techav-homebrew/Wrap030/Software/MultiBasic/libc/00readme.md

This is a subset of gcc libiberty required for the ff library. It is derived from gcc source via https://github.com/gcc-mirror/gcc/
