techav-homebrew/Wrap030/ExpansionBoards/ATX-PSU_8b/039301240.stp

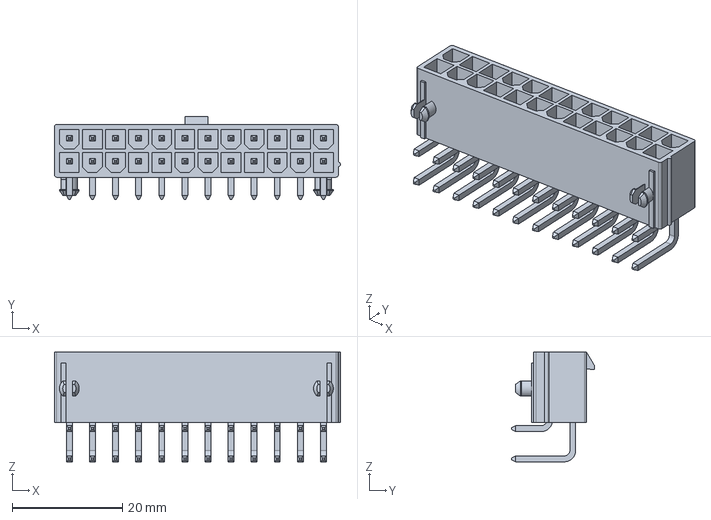
[picture p1: CAD file, 2025-03-29]
ExpansionBoards/ATX-PSU_8b/039301240.stp
52.0 x 15.0 x 19.9 mm
