techav-homebrew/Wrap030/ExpansionBoards/ATX-PSU_8b/ATX-PSU_8b.kicad_pcb

## KiCad design ExpansionBoards/ATX-PSU_8b/ATX-PSU_8b.kicad_pcb (2025-03-29)

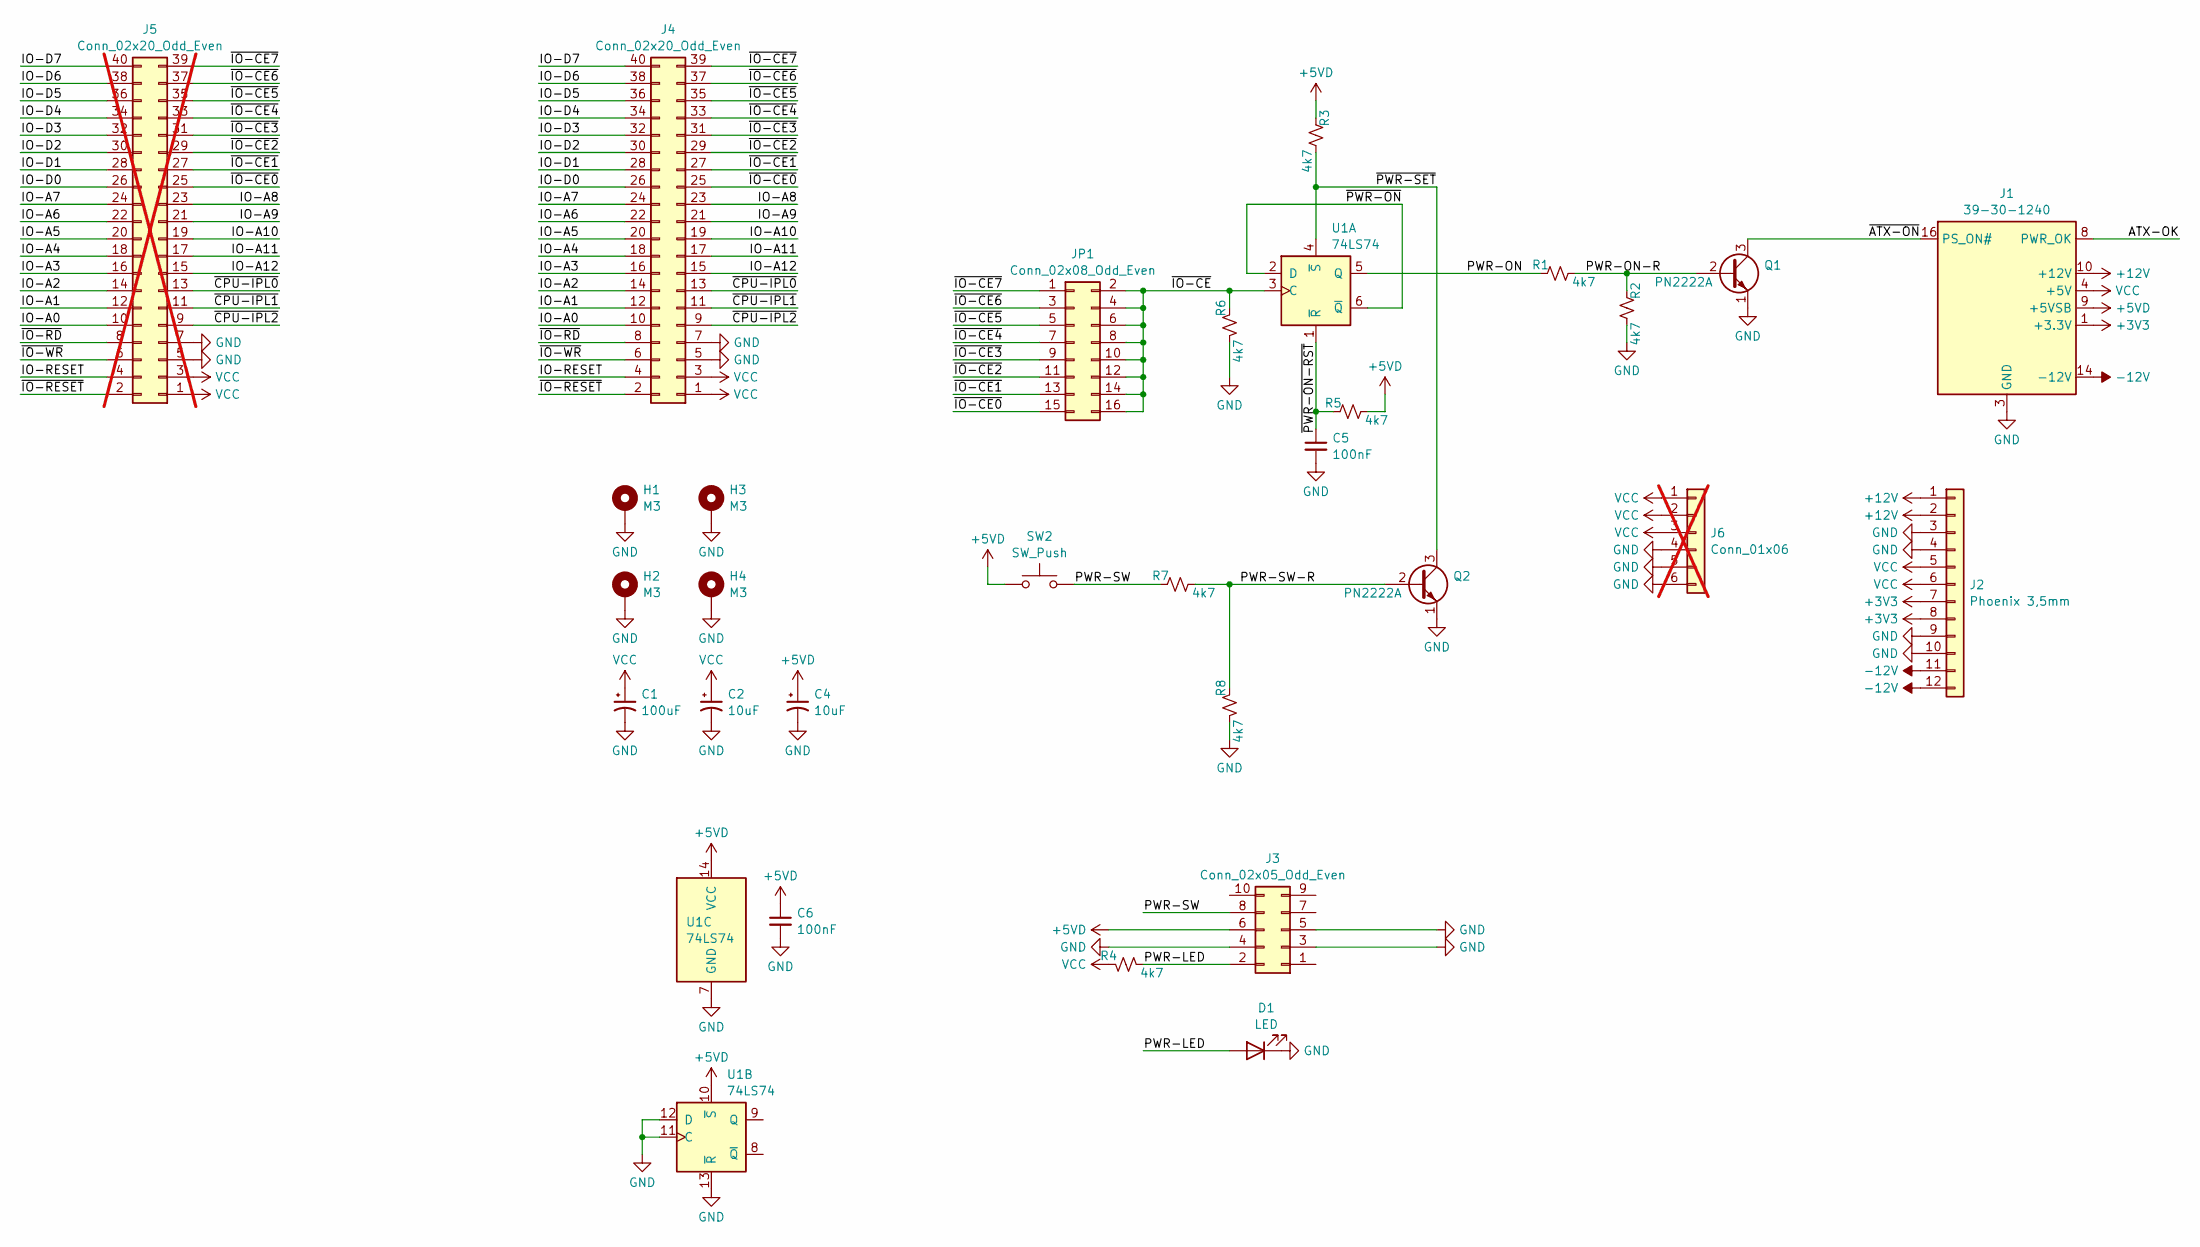
[picture p2: schematic ATX-PSU_8b.kicad_sch]

Parts:
C1: 100uF; CP_Radial_D10.0mm_P5.00mm
C2, C4: 10uF; CP_Radial_D5.0mm_P2.50mm
C5, C6: 100nF; C_Disc_D4.3mm_W1.9mm_P5.00mm
D1: LED; LED_D3.0mm
H1, H2, H3, H4: M3; MountingHole_3.2mm_M3_Pad_Via
J1: 39-30-1240; Molex_Mini-Fit_Jr_5569-24A2_2x12_P4.20mm_Horizontal; Mouser 538-39-30-1240
J2: Phoenix 3,5mm; PhoenixContact_MC_1,5_12-G-3.5_1x12_P3.50mm_Horizontal
J3: Conn_02x05_Odd_Even; IDC-Header_2x05_P2.54mm_Vertical
J4: Conn_02x20_Odd_Even; PinHeader_2x20_P2.54mm_Horizontal
J5: Conn_02x20_Odd_Even; PinHeader_2x20_P2.54mm_Vertical; not fitted
J6: Conn_01x06; PinHeader_1x06_P2.54mm_Vertical; not fitted
JP1: Conn_02x08_Odd_Even; PinHeader_2x08_P2.54mm_Vertical
Q1, Q2: PN2222A; TO-92_Inline
R1, R2, R3, R4, R5, R6, R7, R8: 4k7; R_Axial_DIN0204_L3.6mm_D1.6mm_P7.62mm_Horizontal
SW2: SW_Push; SW_PUSH_6mm_H4.3mm
U1: 74LS74; DIP-14_W7.62mm

Connections:
+3V3: J1.1 (+3.3V), J1.2 (+3.3V), J1.12 (+3.3V), J1.13 (+3.3V), J2.7, J2.8
+5VD: C4.1, C6.1, J1.9 (+5VSB), J3.6, R3.1, R5.2, SW2.1, U1.10 (~S), U1.14 (VCC)
+12V: J1.10 (+12V), J1.11 (+12V), J2.1, J2.2
-12V: J1.14 (-12V), J2.11, J2.12
/ATX-OK: J1.8 (PWR_OK)
/IO-A0: J4.10, J5.10
/IO-A1: J4.12, J5.12
/IO-A2: J4.14, J5.14
/IO-A3: J4.16, J5.16
/IO-A4: J4.18, J5.18
/IO-A5: J4.20, J5.20
/IO-A6: J4.22, J5.22
/IO-A7: J4.24, J5.24
/IO-A8: J4.23, J5.23
/IO-A9: J4.21, J5.21
/IO-A10: J4.19, J5.19
/IO-A11: J4.17, J5.17
/IO-A12: J4.15, J5.15
/IO-D0: J4.26, J5.26
/IO-D1: J4.28, J5.28
/IO-D2: J4.30, J5.30
/IO-D3: J4.32, J5.32
/IO-D4: J4.34, J5.34
/IO-D5: J4.36, J5.36
/IO-D6: J4.38, J5.38
/IO-D7: J4.40, J5.40
/IO-RESET: J4.4, J5.4
/PWR-LED: D1.2 (A), J3.2, R4.1
/PWR-ON: R1.1, U1.5 (Q)
/PWR-ON-R: Q1.2 (B), R1.2, R2.1
/PWR-SW: J3.8, R7.1, SW2.2
/PWR-SW-R: Q2.2 (B), R7.2, R8.1
/~ATX-ON: J1.16 (PS_ON#), Q1.3 (C)
/~CPU-IPL0: J4.13, J5.13
/~CPU-IPL1: J4.11, J5.11
/~CPU-IPL2: J4.9, J5.9
/~IO-CE0: J4.25, J5.25, JP1.15
/~IO-CE1: J4.27, J5.27, JP1.13
/~IO-CE2: J4.29, J5.29, JP1.11
/~IO-CE3: J4.31, J5.31, JP1.9
/~IO-CE4: J4.33, J5.33, JP1.7
/~IO-CE5: J4.35, J5.35, JP1.5
/~IO-CE6: J4.37, J5.37, JP1.3
/~IO-CE7: J4.39, J5.39, JP1.1
/~IO-CE: JP1.2, JP1.4, JP1.6, JP1.8, JP1.10, JP1.12, JP1.14, JP1.16, R6.1, U1.3 (C)
/~IO-RD: J4.8, J5.8
/~IO-RESET: J4.2, J5.2
/~IO-WR: J4.6, J5.6
/~PWR-ON-RST: C5.1, R5.1, U1.1 (~R)
/~PWR-ON: U1.2 (D), U1.6 (~Q)
/~PWR-SET: Q2.3 (C), R3.2, U1.4 (~S)
GND: C1.2, C2.2, C4.2, C5.2, C6.2, D1.1 (K), H1.1, H2.1, H3.1, H4.1, J1.3 (GND), J1.5 (GND), J1.7 (GND), J1.15 (GND), J1.17 (GND), J1.18 (GND), J1.19 (GND), J1.24 (GND), J2.3, J2.4, J2.9, J2.10, J3.3, J3.4, J3.5, J4.5, J4.7, J5.5, J5.7, J6.4, J6.5, J6.6, Q1.1 (E), Q2.1 (E), R2.2, R6.2, R8.2, U1.7 (GND), U1.11 (C), U1.12 (D), U1.13 (~R)
VCC: C1.1, C2.1, J1.4 (+5V), J1.6 (+5V), J1.21 (+5V), J1.22 (+5V), J1.23 (+5V), J2.5, J2.6, J4.1, J4.3, J5.1, J5.3, J6.1, J6.2, J6.3, R4.2

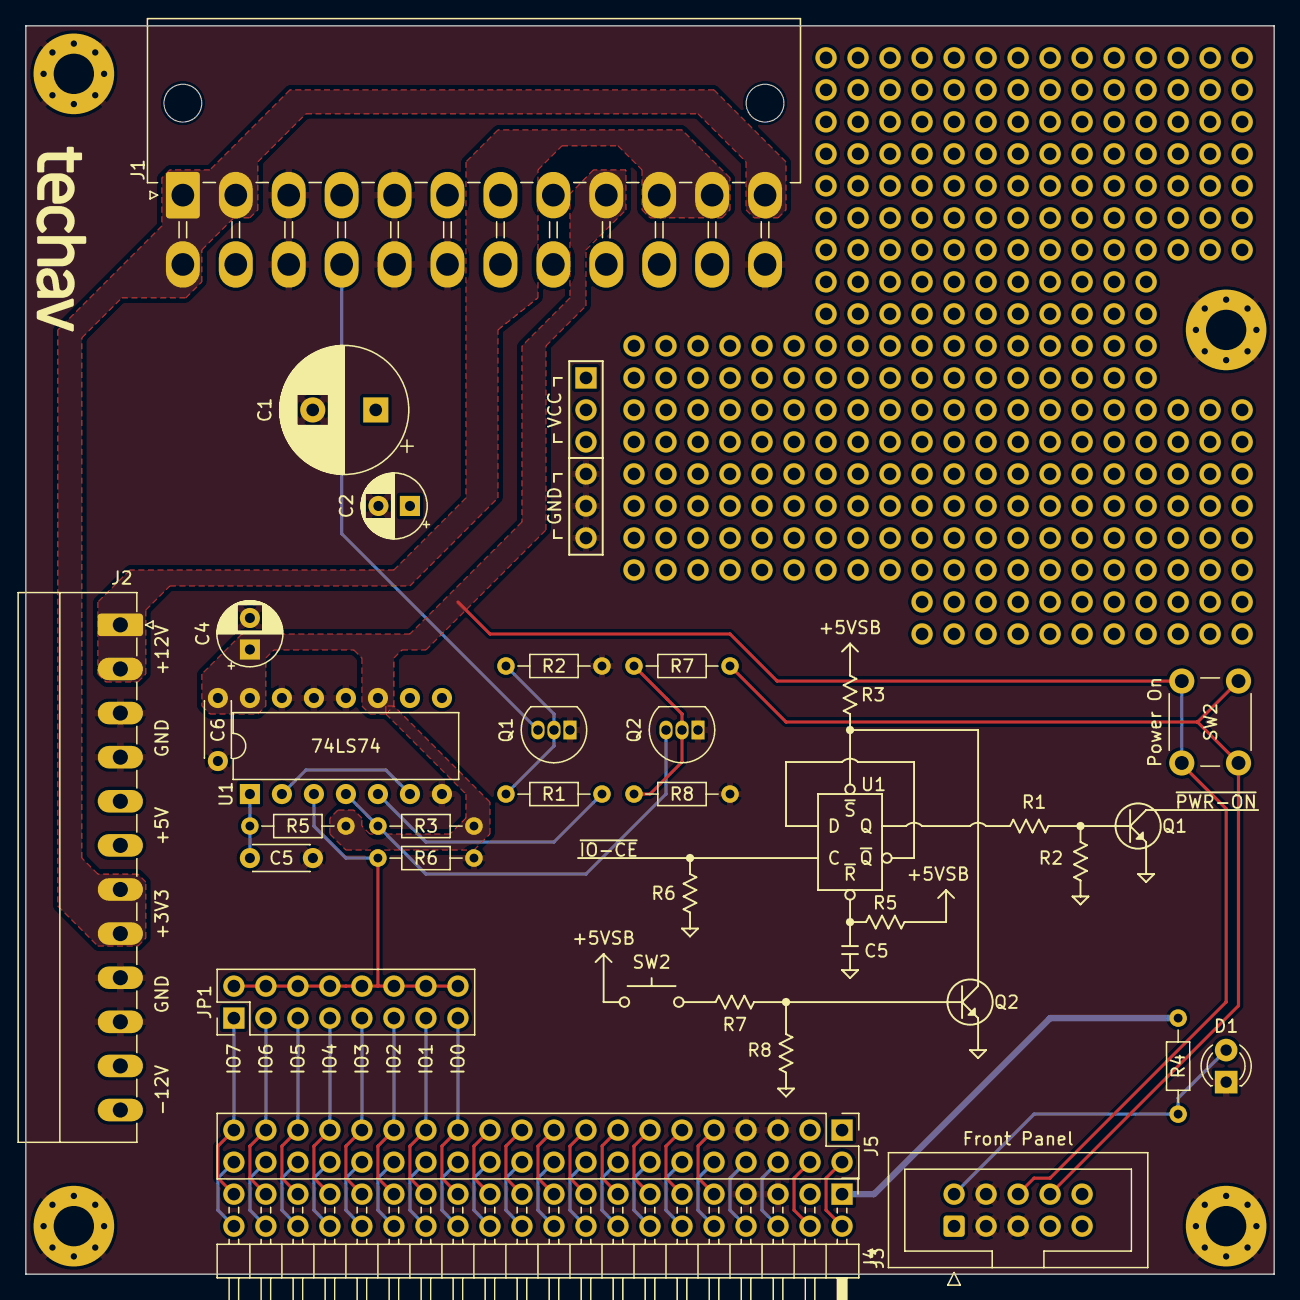
[picture p3: board ATX-PSU_8b.kicad_pcb from above]

Board: 2 copper layers, 99.1 x 99.1 mm, 29 parts (0 on the bottom side), 52 nets.
