techav-homebrew/Wrap030/ExpansionBoards/Exp8b/Exp8b.kicad_pcb

## KiCad design ExpansionBoards/Exp8b/Exp8b.kicad_pcb (2025-03-29)

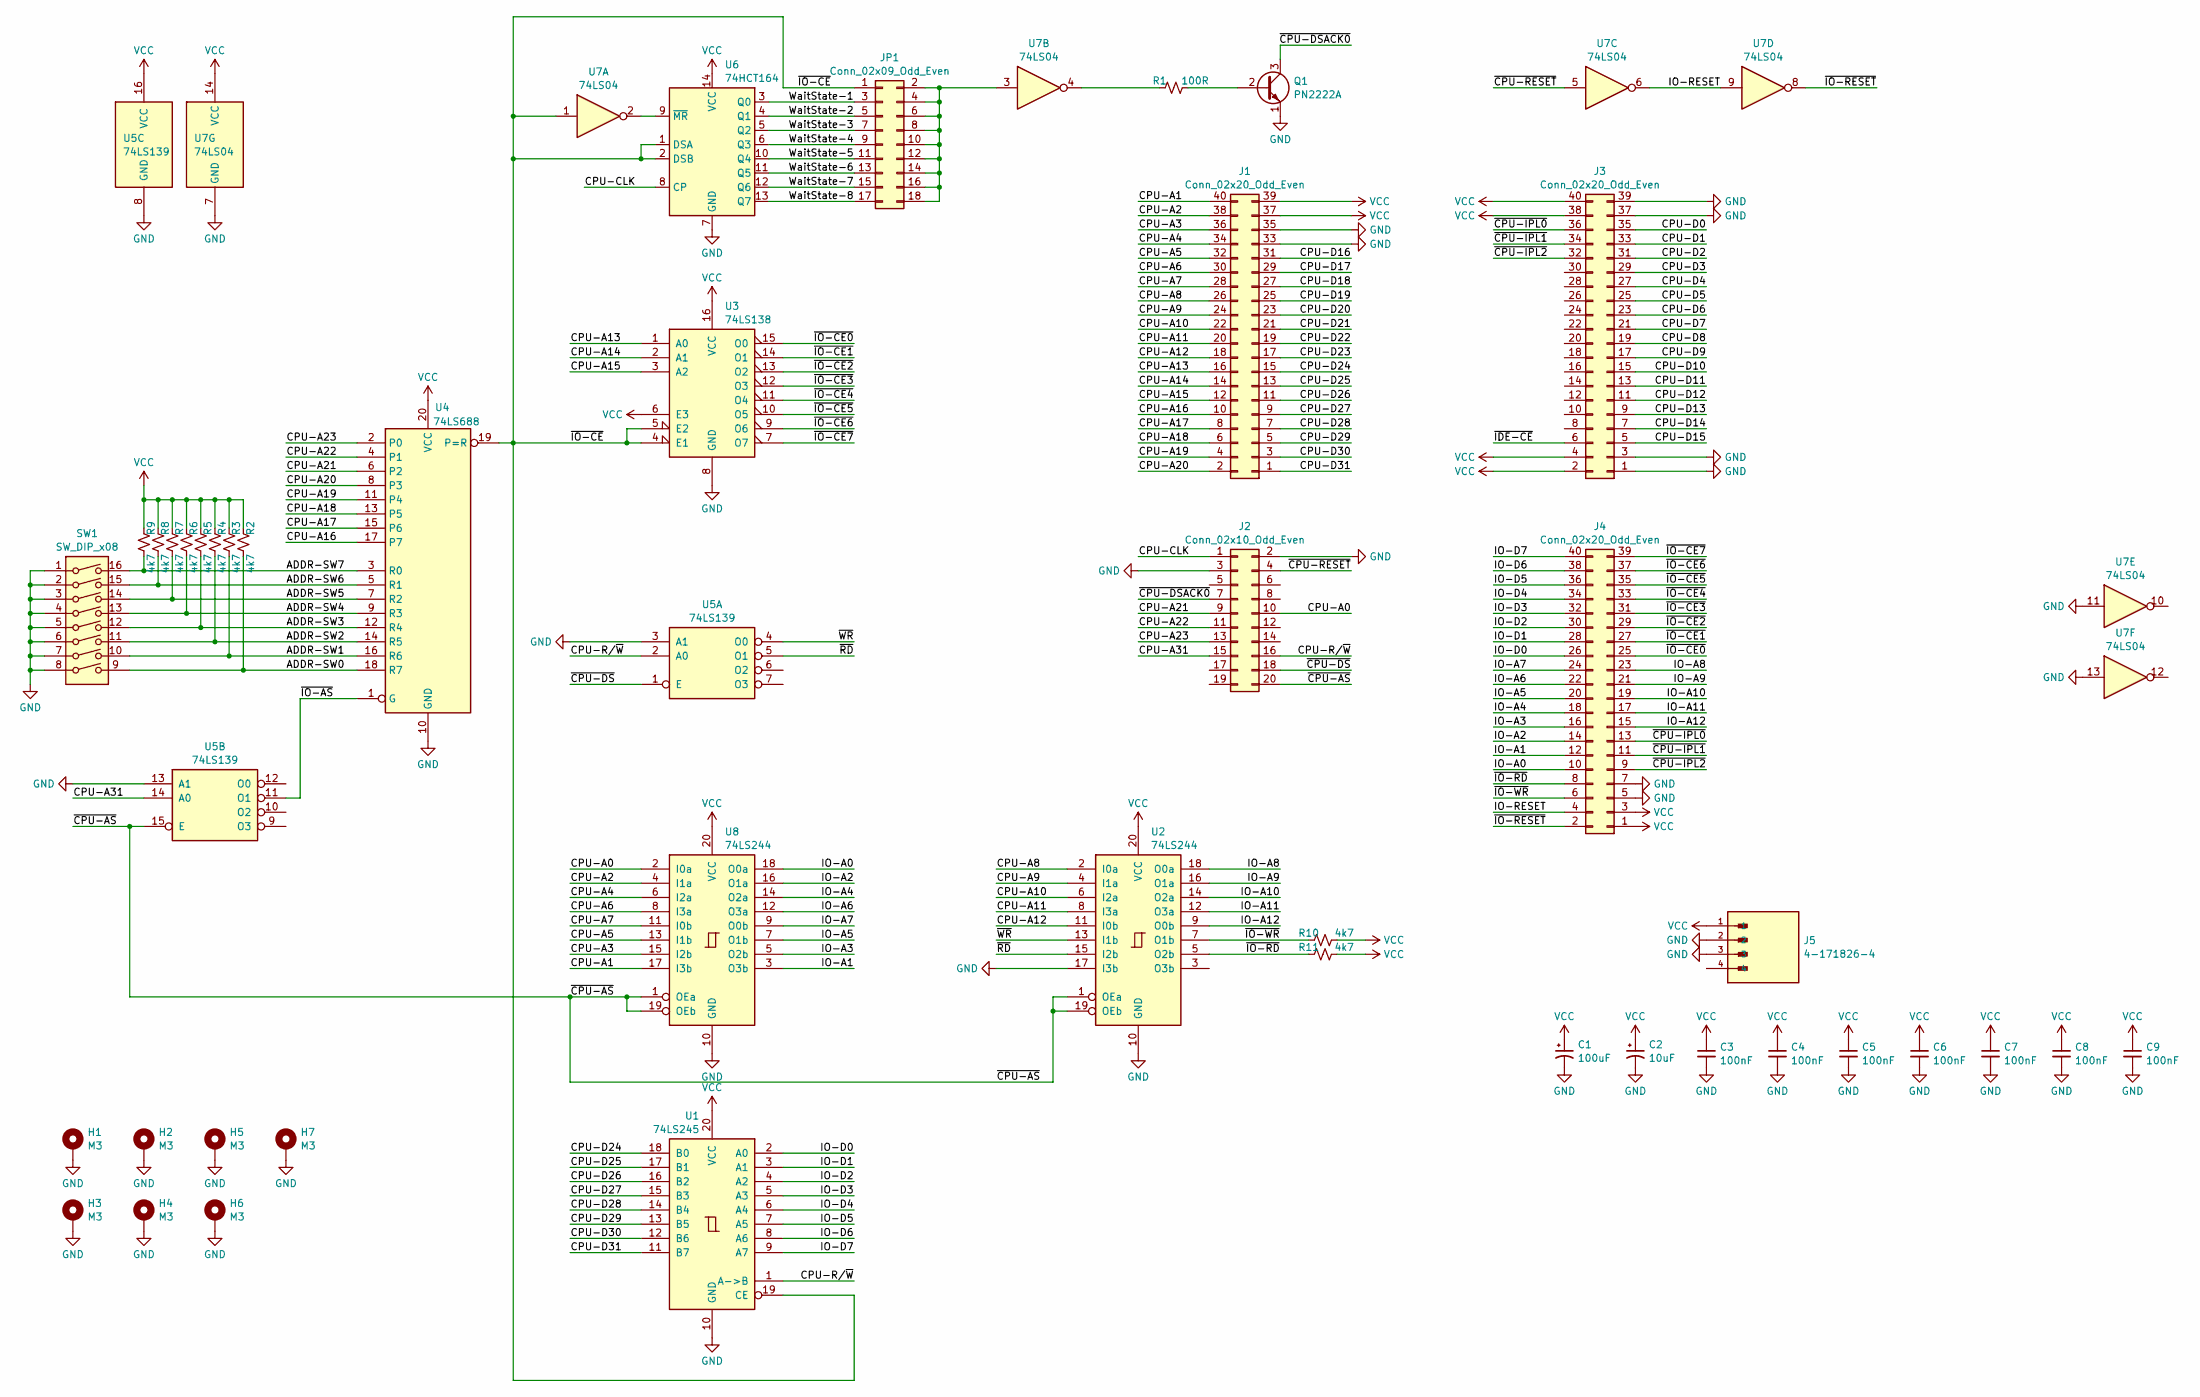
[picture p4: schematic Exp8b.kicad_sch]

Parts:
C1: 100uF; CP_Radial_D10.0mm_P5.00mm
C2: 10uF; CP_Radial_D5.0mm_P2.50mm
C3, C4, C5, C6, C7, C8, C9: 100nF; C_Disc_D4.3mm_W1.9mm_P5.00mm
H1, H2, H3, H4, H5, H6, H7: M3; MountingHole_3.2mm_M3_Pad_Via
J1, J3, J4: Conn_02x20_Odd_Even; PinHeader_2x20_P2.54mm_Horizontal
J2: Conn_02x10_Odd_Even; PinHeader_2x10_P2.54mm_Horizontal
J5: 4-171826-4; TE_4-171826-4
JP1: Conn_02x09_Odd_Even; PinHeader_2x09_P2.54mm_Vertical
Q1: PN2222A; TO-92_Inline
R1: 100R; R_Axial_DIN0204_L3.6mm_D1.6mm_P7.62mm_Horizontal
R2, R3, R4, R5, R6, R7, R8, R9, R10, R11: 4k7; R_Axial_DIN0204_L3.6mm_D1.6mm_P7.62mm_Horizontal
SW1: SW_DIP_x08; SW_DIP_SPSTx08_Slide_9.78x22.5mm_W7.62mm_P2.54mm
U1: 74LS245; DIP-20_W7.62mm_Socket
U2, U8: 74LS244; DIP-20_W7.62mm_Socket
U3: 74LS138; DIP-16_W7.62mm_Socket
U4: 74LS688; DIP-20_W7.62mm_Socket
U5: 74LS139; DIP-16_W7.62mm_Socket
U6: 74HCT164; DIP-14_W7.62mm_Socket
U7: 74LS04; DIP-14_W7.62mm_Socket

Connections:
/ADDR-SW0: R2.2, SW1.9, U4.18 (R7)
/ADDR-SW1: R3.2, SW1.10, U4.16 (R6)
/ADDR-SW2: R4.2, SW1.11, U4.14 (R5)
/ADDR-SW3: R5.2, SW1.12, U4.12 (R4)
/ADDR-SW4: R6.2, SW1.13, U4.9 (R3)
/ADDR-SW5: R7.2, SW1.14, U4.7 (R2)
/ADDR-SW6: R8.2, SW1.15, U4.5 (R1)
/ADDR-SW7: R9.2, SW1.16, U4.3 (R0)
/CPU-A0: J2.10, U8.2 (I0a)
/CPU-A1: J1.40, U8.17 (I3b)
/CPU-A2: J1.38, U8.4 (I1a)
/CPU-A3: J1.36, U8.15 (I2b)
/CPU-A4: J1.34, U8.6 (I2a)
/CPU-A5: J1.32, U8.13 (I1b)
/CPU-A6: J1.30, U8.8 (I3a)
/CPU-A7: J1.28, U8.11 (I0b)
/CPU-A8: J1.26, U2.2 (I0a)
/CPU-A9: J1.24, U2.4 (I1a)
/CPU-A10: J1.22, U2.6 (I2a)
/CPU-A11: J1.20, U2.8 (I3a)
/CPU-A12: J1.18, U2.11 (I0b)
/CPU-A13: J1.16, U3.1 (A0)
/CPU-A14: J1.14, U3.2 (A1)
/CPU-A15: J1.12, U3.3 (A2)
/CPU-A16: J1.10, U4.17 (P7)
/CPU-A17: J1.8, U4.15 (P6)
/CPU-A18: J1.6, U4.13 (P5)
/CPU-A19: J1.4, U4.11 (P4)
/CPU-A20: J1.2, U4.8 (P3)
/CPU-A21: J2.9, U4.6 (P2)
/CPU-A22: J2.11, U4.4 (P1)
/CPU-A23: J2.13, U4.2 (P0)
/CPU-A31: J2.15, U5.14 (A0)
/CPU-CLK: J2.1, U6.8 (CP)
/CPU-D0: J3.35
/CPU-D1: J3.33
/CPU-D2: J3.31
/CPU-D3: J3.29
/CPU-D4: J3.27
/CPU-D5: J3.25
/CPU-D6: J3.23
/CPU-D7: J3.21
/CPU-D8: J3.19
/CPU-D9: J3.17
/CPU-D10: J3.15
/CPU-D11: J3.13
/CPU-D12: J3.11
/CPU-D13: J3.9
/CPU-D14: J3.7
/CPU-D15: J3.5
/CPU-D16: J1.31
/CPU-D17: J1.29
/CPU-D18: J1.27
/CPU-D19: J1.25
/CPU-D20: J1.23
/CPU-D21: J1.21
/CPU-D22: J1.19
/CPU-D23: J1.17
/CPU-D24: J1.15, U1.18 (B0)
/CPU-D25: J1.13, U1.17 (B1)
/CPU-D26: J1.11, U1.16 (B2)
/CPU-D27: J1.9, U1.15 (B3)
/CPU-D28: J1.7, U1.14 (B4)
/CPU-D29: J1.5, U1.13 (B5)
/CPU-D30: J1.3, U1.12 (B6)
/CPU-D31: J1.1, U1.11 (B7)
/CPU-R/~W: J2.16, U1.1 (A->B), U5.2 (A0)
/IO-A0: J4.10, U8.18 (O0a)
/IO-A1: J4.12, U8.3 (O3b)
/IO-A2: J4.14, U8.16 (O1a)
/IO-A3: J4.16, U8.5 (O2b)
/IO-A4: J4.18, U8.14 (O2a)
/IO-A5: J4.20, U8.7 (O1b)
/IO-A6: J4.22, U8.12 (O3a)
/IO-A7: J4.24, U8.9 (O0b)
/IO-A8: J4.23, U2.18 (O0a)
/IO-A9: J4.21, U2.16 (O1a)
/IO-A10: J4.19, U2.14 (O2a)
/IO-A11: J4.17, U2.12 (O3a)
/IO-A12: J4.15, U2.9 (O0b)
/IO-D0: J4.26, U1.2 (A0)
/IO-D1: J4.28, U1.3 (A1)
/IO-D2: J4.30, U1.4 (A2)
/IO-D3: J4.32, U1.5 (A3)
/IO-D4: J4.34, U1.6 (A4)
/IO-D5: J4.36, U1.7 (A5)
/IO-D6: J4.38, U1.8 (A6)
/IO-D7: J4.40, U1.9 (A7)
/IO-RESET: J4.4, U7.6, U7.9
/WaitState-1: JP1.3, U6.3 (Q0)
/WaitState-2: JP1.5, U6.4 (Q1)
/WaitState-3: JP1.7, U6.5 (Q2)
/WaitState-4: JP1.9, U6.6 (Q3)
/WaitState-5: JP1.11, U6.10 (Q4)
/WaitState-6: JP1.13, U6.11 (Q5)
/WaitState-7: JP1.15, U6.12 (Q6)
/WaitState-8: JP1.17, U6.13 (Q7)
/~CPU-AS: J2.20, U2.1 (OEa), U2.19 (OEb), U5.15 (E), U8.1 (OEa), U8.19 (OEb)
/~CPU-DSACK0: J2.7, Q1.3 (C)
/~CPU-DS: J2.18, U5.1 (E)
/~CPU-IPL0: J3.36, J4.13
/~CPU-IPL1: J3.34, J4.11
/~CPU-IPL2: J3.32, J4.9
/~CPU-RESET: J2.4, U7.5
/~IDE-CE: J3.6
/~IO-AS: U4.1 (G), U5.11 (O1)
/~IO-CE0: J4.25, U3.15 (O0)
/~IO-CE1: J4.27, U3.14 (O1)
/~IO-CE2: J4.29, U3.13 (O2)
/~IO-CE3: J4.31, U3.12 (O3)
/~IO-CE4: J4.33, U3.11 (O4)
/~IO-CE5: J4.35, U3.10 (O5)
/~IO-CE6: J4.37, U3.9 (O6)
/~IO-CE7: J4.39, U3.7 (O7)
/~IO-CE: JP1.1, U1.19 (CE), U3.4 (E1), U3.5 (E2), U4.19 (P=R), U6.1 (DSA), U6.2 (DSB), U7.1
/~IO-RD: J4.8, R11.1, U2.5 (O2b)
/~IO-RESET: J4.2, U7.8
/~IO-WR: J4.6, R10.1, U2.7 (O1b)
/~RD: U2.15 (I2b), U5.5 (O1)
/~WR: U2.13 (I1b), U5.4 (O0)
GND: C1.2, C2.2, C3.2, C4.2, C5.2, C6.2, C7.2, C8.2, C9.2, H1.1, H2.1, H3.1, H4.1, H5.1, H6.1, H7.1, J1.33, J1.35, J2.2, J2.3, J3.1, J3.3, J3.37, J3.39, J4.5, J4.7, J5.2, J5.3, Q1.1 (E), SW1.1, SW1.2, SW1.3, SW1.4, SW1.5, SW1.6, SW1.7, SW1.8, U1.10 (GND), U2.10 (GND), U2.17 (I3b), U3.8 (GND), U4.10 (GND), U5.3 (A1), U5.8 (GND), U5.13 (A1), U6.7 (GND), U7.7 (GND), U7.11, U7.13, U8.10 (GND)
unnamed: JP1.2, JP1.4, JP1.6, JP1.8, JP1.10, JP1.12, JP1.14, JP1.16, JP1.18, U7.3
unnamed: Q1.2 (B), R1.2
unnamed: R1.1, U7.4
unnamed: U6.9 (~MR), U7.2
VCC: C1.1, C2.1, C3.1, C4.1, C5.1, C6.1, C7.1, C8.1, C9.1, J1.37, J1.39, J3.2, J3.4, J3.38, J3.40, J4.1, J4.3, J5.1, R2.1, R3.1, R4.1, R5.1, R6.1, R7.1, R8.1, R9.1, R10.2, R11.2, U1.20 (VCC), U2.20 (VCC), U3.6 (E3), U3.16 (VCC), U4.20 (VCC), U5.16 (VCC), U6.14 (VCC), U7.14 (VCC), U8.20 (VCC)

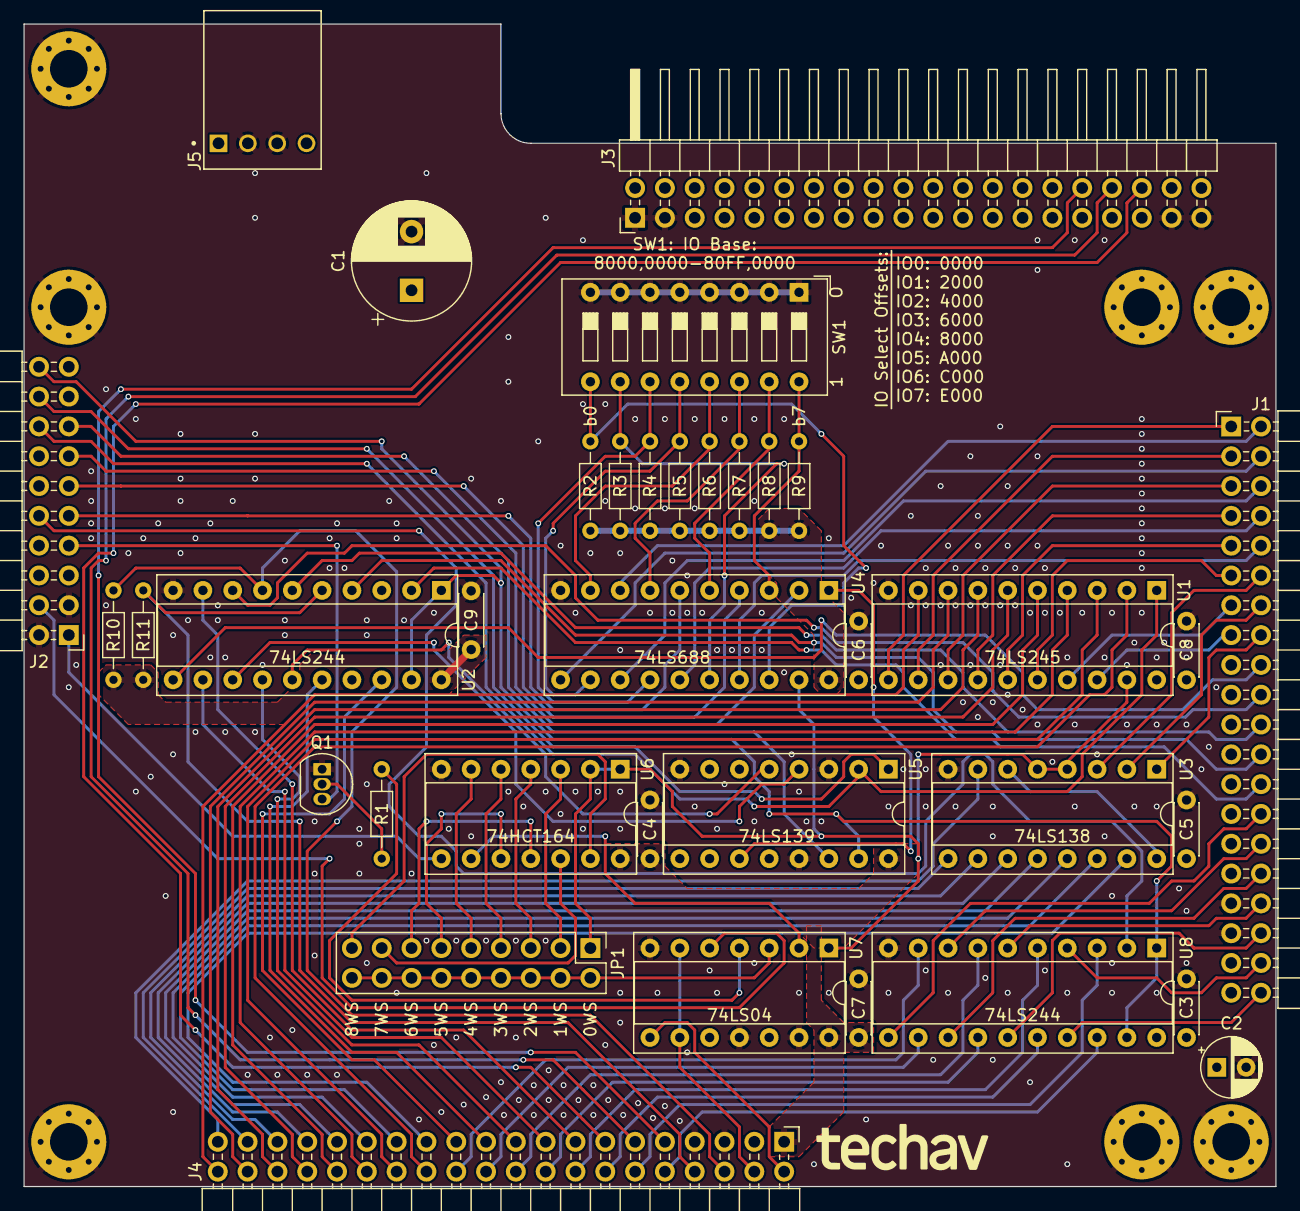
[picture p5: board Exp8b.kicad_pcb from above]

Board: 2 copper layers, 106.7 x 99.1 mm, 43 parts (0 on the bottom side), 101 nets.
