techav-homebrew/Wrap030/ExpansionBoards/QuadCom_8b/QuadCom_8b.kicad_pcb

## KiCad design ExpansionBoards/QuadCom_8b/QuadCom_8b.kicad_pcb (2025-03-29)

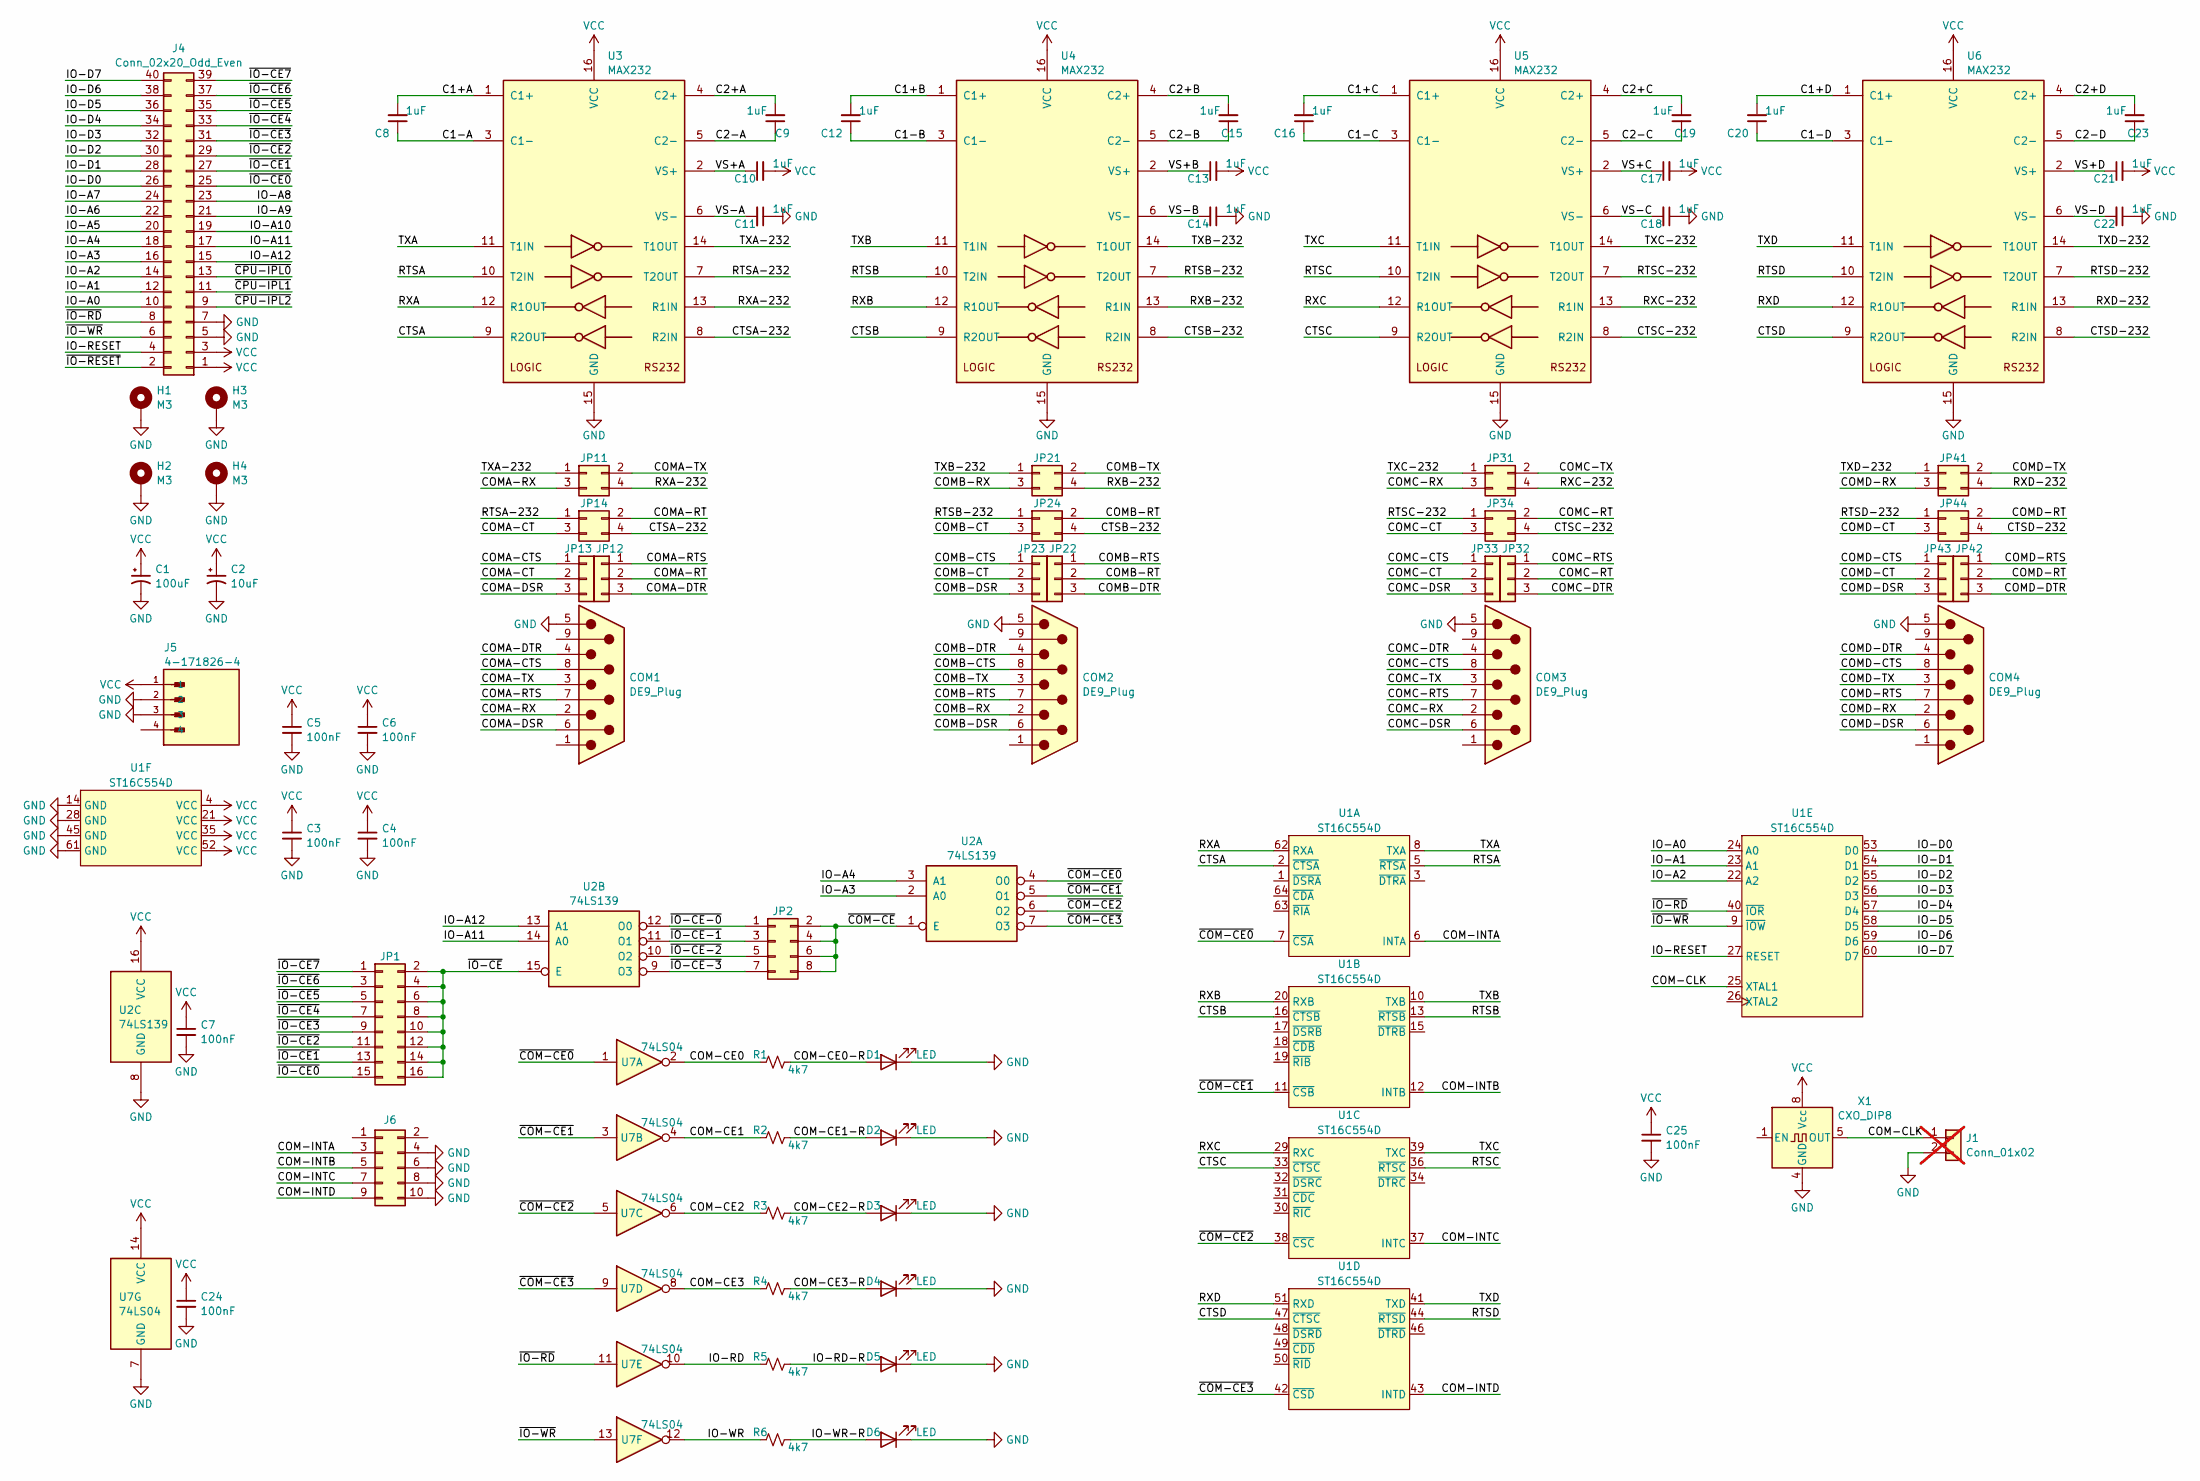
[picture p6: schematic QuadCom_8b.kicad_sch]

Parts:
C1: 100uF; CP_Radial_D10.0mm_P5.00mm
C2: 10uF; CP_Radial_D5.0mm_P2.50mm
C3, C4, C5, C6, C7, C24, C25: 100nF; C_Disc_D4.3mm_W1.9mm_P5.00mm
C8, C9, C10, C11, C12, C13, C14, C15, C16, C17, C18, C19, C20, C21, C22, C23: 1uF; C_Disc_D4.3mm_W1.9mm_P5.00mm
COM1, COM2, COM3, COM4: DE9_Plug; DSUB-9_Male_EdgeMount_P2.77mm
D1, D2, D3, D4, D5, D6: LED; LED_D3.0mm_Horizontal_O1.27mm_Z2.0mm
H1, H2, H3, H4: M3; MountingHole_3.2mm_M3_Pad_Via
J1: Conn_01x02; PinHeader_1x02_P2.54mm_Vertical; not fitted
J4: Conn_02x20_Odd_Even; PinHeader_2x20_P2.54mm_Horizontal
J5: 4-171826-4; TE_4-171826-4
J6: Conn_02x05_Odd_Even; IDC-Header_2x05_P2.54mm_Vertical
JP1: Conn_02x08_Odd_Even; PinHeader_2x08_P2.54mm_Vertical
JP2: Conn_02x04_Odd_Even; PinHeader_2x04_P2.54mm_Vertical
JP11, JP14, JP21, JP24, JP31, JP34, JP41, JP44: Conn_02x02_Odd_Even; PinHeader_2x02_P2.54mm_Vertical
JP12, JP13, JP22, JP23, JP32, JP33, JP42, JP43: Conn_01x03; PinHeader_1x03_P2.54mm_Vertical
R1, R2, R3, R4, R5, R6: 4k7; R_Axial_DIN0204_L3.6mm_D1.6mm_P7.62mm_Horizontal
U1: ST16C554D; LQFP-64_10x10mm_P0.5mm; Mouser 701-ST16C554DIQ64-F
U2: 74LS139; DIP-16_W7.62mm
U3, U4, U5, U6: MAX232; DIP-16_W7.62mm
U7: 74LS04; DIP-14_W7.62mm
X1: CXO_DIP8; Oscillator_DIP-8

Connections:
/C1+A: C8.2, U3.1 (C1+)
/C1+B: C12.2, U4.1 (C1+)
/C1+C: C16.2, U5.1 (C1+)
/C1+D: C20.2, U6.1 (C1+)
/C1-A: C8.1, U3.3 (C1-)
/C1-B: C12.1, U4.3 (C1-)
/C1-C: C16.1, U5.3 (C1-)
/C1-D: C20.1, U6.3 (C1-)
/C2+A: C9.2, U3.4 (C2+)
/C2+B: C15.2, U4.4 (C2+)
/C2+C: C19.2, U5.4 (C2+)
/C2+D: C23.2, U6.4 (C2+)
/C2-A: C9.1, U3.5 (C2-)
/C2-B: C15.1, U4.5 (C2-)
/C2-C: C19.1, U5.5 (C2-)
/C2-D: C23.1, U6.5 (C2-)
/COM-CE0: R1.1, U7.2
/COM-CE0-R: D1.2 (A), R1.2
/COM-CE1: R2.1, U7.4
/COM-CE1-R: D2.2 (A), R2.2
/COM-CE2: R3.1, U7.6
/COM-CE2-R: D3.2 (A), R3.2
/COM-CE3: R4.1, U7.8
/COM-CE3-R: D4.2 (A), R4.2
/COM-CLK: J1.1, U1.25 (XTAL1), X1.5 (OUT)
/COM-INTA: J6.3, U1.6 (INTA)
/COM-INTB: J6.5, U1.12 (INTB)
/COM-INTC: J6.7, U1.37 (INTC)
/COM-INTD: J6.9, U1.43 (INTD)
/COMA-CT: JP13.2, JP14.3
/COMA-CTS: COM1.8, JP13.1
/COMA-DSR: COM1.6, JP13.3
/COMA-DTR: COM1.4, JP12.3
/COMA-RT: JP12.2, JP14.2
/COMA-RTS: COM1.7, JP12.1
/COMA-RX: COM1.2, JP11.3
/COMA-TX: COM1.3, JP11.2
/COMB-CT: JP23.2, JP24.3
/COMB-CTS: COM2.8, JP23.1
/COMB-DSR: COM2.6, JP23.3
/COMB-DTR: COM2.4, JP22.3
/COMB-RT: JP22.2, JP24.2
/COMB-RTS: COM2.7, JP22.1
/COMB-RX: COM2.2, JP21.3
/COMB-TX: COM2.3, JP21.2
/COMC-CT: JP33.2, JP34.3
/COMC-CTS: COM3.8, JP33.1
/COMC-DSR: COM3.6, JP33.3
/COMC-DTR: COM3.4, JP32.3
/COMC-RT: JP32.2, JP34.2
/COMC-RTS: COM3.7, JP32.1
/COMC-RX: COM3.2, JP31.3
/COMC-TX: COM3.3, JP31.2
/COMD-CT: JP43.2, JP44.3
/COMD-CTS: COM4.8, JP43.1
/COMD-DSR: COM4.6, JP43.3
/COMD-DTR: COM4.4, JP42.3
/COMD-RT: JP42.2, JP44.2
/COMD-RTS: COM4.7, JP42.1
/COMD-RX: COM4.2, JP41.3
/COMD-TX: COM4.3, JP41.2
/CTSA: U1.2 (~CTSA), U3.9 (R2OUT)
/CTSA-232: JP14.4, U3.8 (R2IN)
/CTSB: U1.16 (~CTSB), U4.9 (R2OUT)
/CTSB-232: JP24.4, U4.8 (R2IN)
/CTSC: U1.33 (~CTSC), U5.9 (R2OUT)
/CTSC-232: JP34.4, U5.8 (R2IN)
/CTSD: U1.47 (~CTSC), U6.9 (R2OUT)
/CTSD-232: JP44.4, U6.8 (R2IN)
/IO-A0: J4.10, U1.24 (A0)
/IO-A1: J4.12, U1.23 (A1)
/IO-A2: J4.14, U1.22 (A2)
/IO-A3: J4.16, U2.2 (A0)
/IO-A4: J4.18, U2.3 (A1)
/IO-A5: J4.20
/IO-A6: J4.22
/IO-A7: J4.24
/IO-A8: J4.23
/IO-A9: J4.21
/IO-A10: J4.19
/IO-A11: J4.17, U2.14 (A0)
/IO-A12: J4.15, U2.13 (A1)
/IO-D0: J4.26, U1.53 (D0)
/IO-D1: J4.28, U1.54 (D1)
/IO-D2: J4.30, U1.55 (D2)
/IO-D3: J4.32, U1.56 (D3)
/IO-D4: J4.34, U1.57 (D4)
/IO-D5: J4.36, U1.58 (D5)
/IO-D6: J4.38, U1.59 (D6)
/IO-D7: J4.40, U1.60 (D7)
/IO-RD: R5.1, U7.10
/IO-RD-R: D5.2 (A), R5.2
/IO-RESET: J4.4, U1.27 (RESET)
/IO-WR: R6.1, U7.12
/IO-WR-R: D6.2 (A), R6.2
/RTSA: U1.5 (~RTSA), U3.10 (T2IN)
/RTSA-232: JP14.1, U3.7 (T2OUT)
/RTSB: U1.13 (~RTSB), U4.10 (T2IN)
/RTSB-232: JP24.1, U4.7 (T2OUT)
/RTSC: U1.36 (~RTSC), U5.10 (T2IN)
/RTSC-232: JP34.1, U5.7 (T2OUT)
/RTSD: U1.44 (~RTSD), U6.10 (T2IN)
/RTSD-232: JP44.1, U6.7 (T2OUT)
/RXA: U1.62 (RXA), U3.12 (R1OUT)
/RXA-232: JP11.4, U3.13 (R1IN)
/RXB: U1.20 (RXB), U4.12 (R1OUT)
/RXB-232: JP21.4, U4.13 (R1IN)
/RXC: U1.29 (RXC), U5.12 (R1OUT)
/RXC-232: JP31.4, U5.13 (R1IN)
/RXD: U1.51 (RXD), U6.12 (R1OUT)
/RXD-232: JP41.4, U6.13 (R1IN)
/TXA: U1.8 (TXA), U3.11 (T1IN)
/TXA-232: JP11.1, U3.14 (T1OUT)
/TXB: U1.10 (TXB), U4.11 (T1IN)
/TXB-232: JP21.1, U4.14 (T1OUT)
/TXC: U1.39 (TXC), U5.11 (T1IN)
/TXC-232: JP31.1, U5.14 (T1OUT)
/TXD: U1.41 (TXD), U6.11 (T1IN)
/TXD-232: JP41.1, U6.14 (T1OUT)
/VS+A: C10.1, U3.2 (VS+)
/VS+B: C13.1, U4.2 (VS+)
/VS+C: C17.1, U5.2 (VS+)
/VS+D: C21.1, U6.2 (VS+)
/VS-A: C11.2, U3.6 (VS-)
/VS-B: C14.2, U4.6 (VS-)
/VS-C: C18.2, U5.6 (VS-)
/VS-D: C22.2, U6.6 (VS-)
/~COM-CE0: U1.7 (~CSA), U2.4 (O0), U7.1
/~COM-CE1: U1.11 (~CSB), U2.5 (O1), U7.3
/~COM-CE2: U1.38 (~CSC), U2.6 (O2), U7.5
/~COM-CE3: U1.42 (~CSD), U2.7 (O3), U7.9
/~COM-CE: JP2.2, JP2.4, JP2.6, JP2.8, U2.1 (E)
/~CPU-IPL0: J4.13
/~CPU-IPL1: J4.11
/~CPU-IPL2: J4.9
/~IO-CE0: J4.25, JP1.15
/~IO-CE1: J4.27, JP1.13
/~IO-CE2: J4.29, JP1.11
/~IO-CE3: J4.31, JP1.9
/~IO-CE4: J4.33, JP1.7
/~IO-CE5: J4.35, JP1.5
/~IO-CE6: J4.37, JP1.3
/~IO-CE7: J4.39, JP1.1
/~IO-CE-0: JP2.1, U2.12 (O0)
/~IO-CE-1: JP2.3, U2.11 (O1)
/~IO-CE-2: JP2.5, U2.10 (O2)
/~IO-CE-3: JP2.7, U2.9 (O3)
/~IO-CE: JP1.2, JP1.4, JP1.6, JP1.8, JP1.10, JP1.12, JP1.14, JP1.16, U2.15 (E)
/~IO-RD: J4.8, U1.40 (~IOR), U7.11
/~IO-RESET: J4.2
/~IO-WR: J4.6, U1.9 (~IOW), U7.13
GND: C1.2, C2.2, C3.2, C4.2, C5.2, C6.2, C7.2, C11.1, C14.1, C18.1, C22.1, C24.2, C25.2, COM1.5, COM2.5, COM3.5, COM4.5, D1.1 (K), D2.1 (K), D3.1 (K), D4.1 (K), D5.1 (K), D6.1 (K), H1.1, H2.1, H3.1, H4.1, J1.2, J4.5, J4.7, J5.2, J5.3, J6.4, J6.6, J6.8, J6.10, U1.14 (GND), U1.28 (GND), U1.45 (GND), U1.61 (GND), U2.8 (GND), U3.15 (GND), U4.15 (GND), U5.15 (GND), U6.15 (GND), U7.7 (GND), X1.4 (GND)
VCC: C1.1, C2.1, C3.1, C4.1, C5.1, C6.1, C7.1, C10.2, C13.2, C17.2, C21.2, C24.1, C25.1, J4.1, J4.3, J5.1, U1.4 (VCC), U1.21 (VCC), U1.35 (VCC), U1.52 (VCC), U2.16 (VCC), U3.16 (VCC), U4.16 (VCC), U5.16 (VCC), U6.16 (VCC), U7.14 (VCC), X1.8 (Vcc)

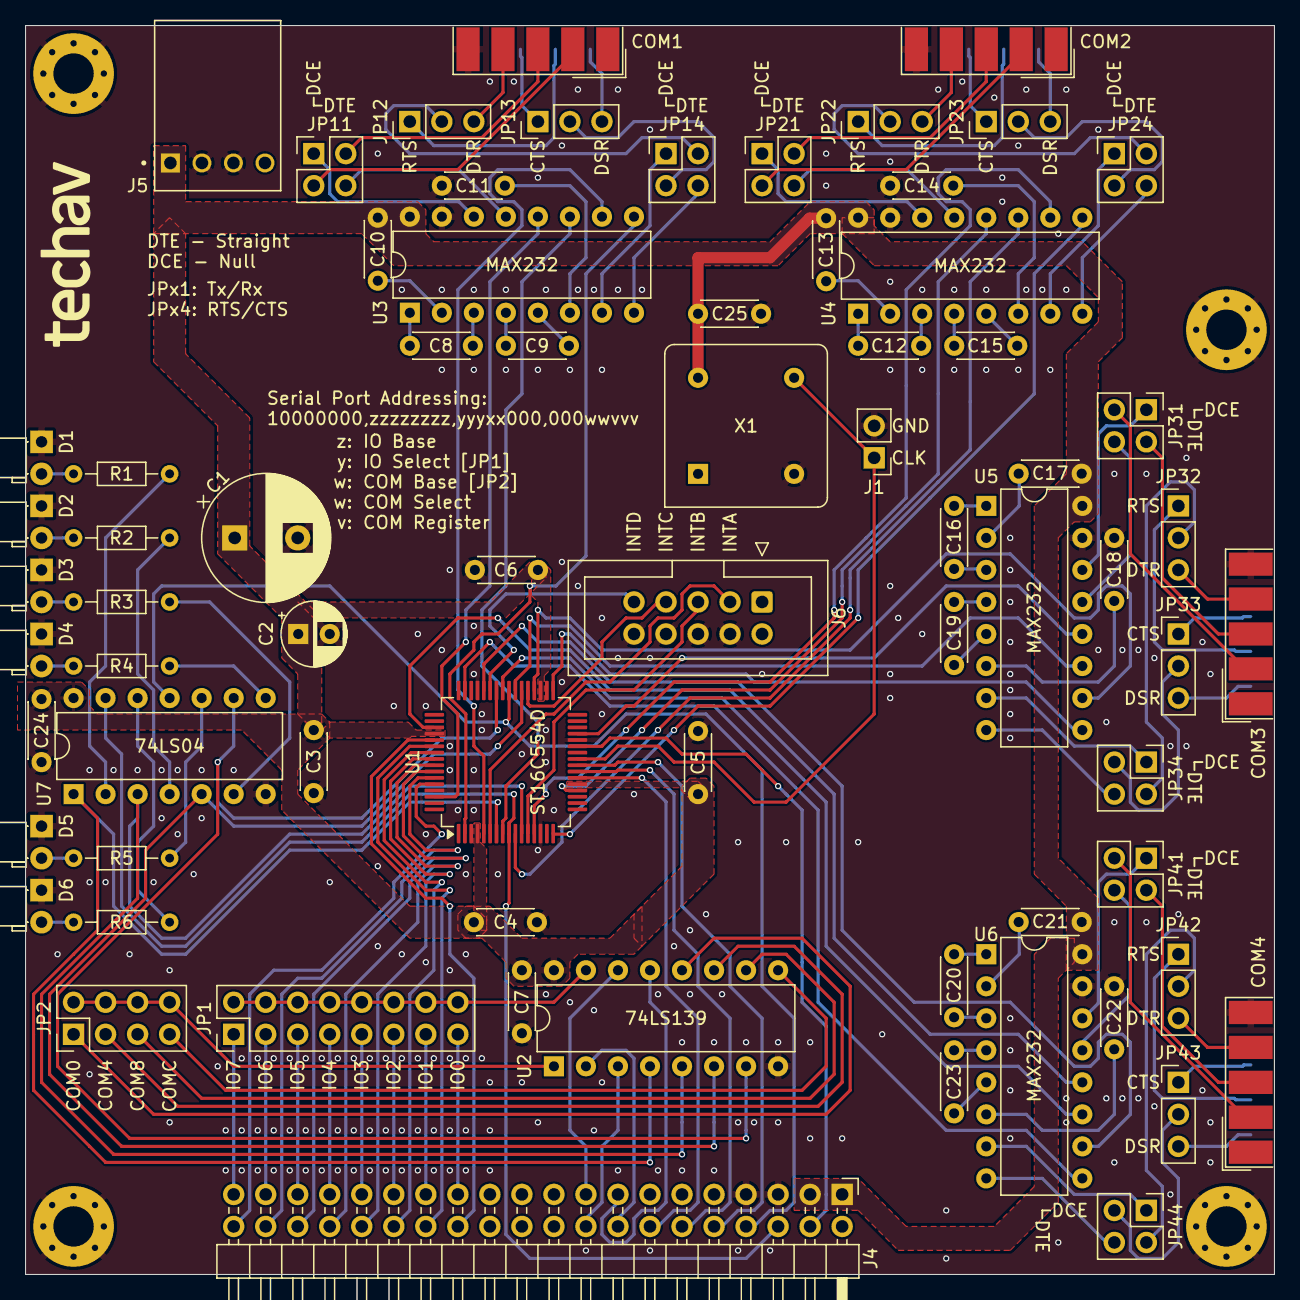
[picture p7: board QuadCom_8b.kicad_pcb from above]

Board: 2 copper layers, 99.1 x 99.1 mm, 75 parts (0 on the bottom side), 143 nets.
