techav-homebrew/Wrap030/ExpansionBoards/Memory/Project/Wrap030 Memory.sch

## EAGLE design ExpansionBoards/Memory/Project/Wrap030 Memory.sch (2025-05-25)

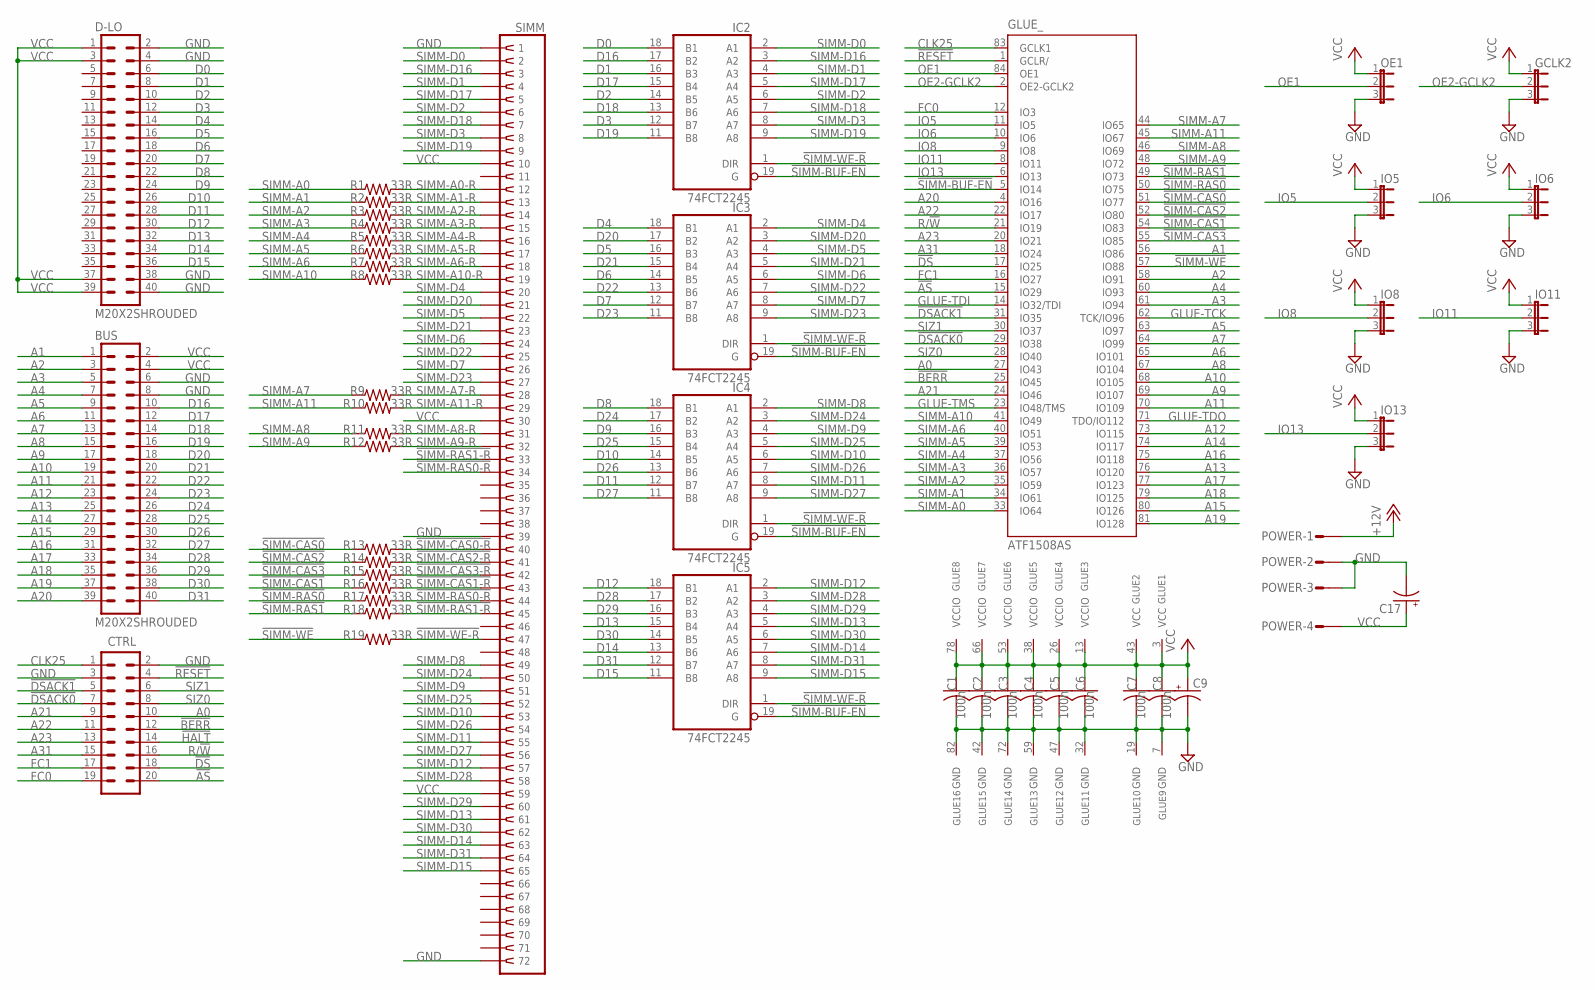
[picture p8: schematic Wrap030 Memory.sch]

Parts:
BUS: M20X2SHROUDED; 2X20_SHROUDED
C1, C2, C3, C4, C5, C6, C7, C8: 100n; C0805
C9: CPOL-USE2-5; E2-5
C17: CPOL-USE3.5-8; E3,5-8
CTRL: M10X2; 2X10
D-LO: M20X2SHROUDED; 2X20_SHROUDED
GCLK2: JP2E; JP2
GLUE: ATF1508AS; S84
IC2, IC3, IC4, IC5: 74FCT2245; SO20W
IO5, IO6, IO8, IO11, IO13: JP2E; JP2
OE1: JP2E; JP2
POWER: L04P
R1, R2, R3, R4, R5, R6, R7, R8, R9, R10, R11, R12, R13, R14, R15, R16, R17, R18, R19: 33R; R0805
SIMM: SIMM72; 73826962

Connections:
!AS: CTRL.20, GLUE.15 (IO29)
!BERR: CTRL.12, GLUE.25 (IO45)
!DS: CTRL.18, GLUE.17 (IO25)
!DSACK0: CTRL.7, GLUE.29 (IO38)
!DSACK1: CTRL.5, GLUE.31 (IO35)
!HALT: CTRL.14
!RESET: CTRL.4, GLUE.1 (GCLR/)
!SIMM-BUF-EN: GLUE.5 (IO14), IC2.19 (G), IC3.19 (G), IC4.19 (G), IC5.19 (G)
!SIMM-CAS0: GLUE.51 (IO77), R13.1
!SIMM-CAS0-R: R13.2, SIMM.40
!SIMM-CAS1: GLUE.54 (IO83), R16.1
!SIMM-CAS1-R: R16.2, SIMM.43
!SIMM-CAS2: GLUE.52 (IO80), R14.1
!SIMM-CAS2-R: R14.2, SIMM.41
!SIMM-CAS3: GLUE.55 (IO85), R15.1
!SIMM-CAS3-R: R15.2, SIMM.42
!SIMM-RAS0: GLUE.50 (IO75), R17.1
!SIMM-RAS0-R: R17.2, SIMM.34, SIMM.44
!SIMM-RAS1: GLUE.49 (IO73), R18.1
!SIMM-RAS1-R: R18.2, SIMM.33, SIMM.45
!SIMM-WE: GLUE.57 (IO88), R19.1
!SIMM-WE-R: IC2.1 (DIR), IC3.1 (DIR), IC4.1 (DIR), IC5.1 (DIR), R19.2, SIMM.47
+12V: POWER.1
A0: CTRL.10, GLUE.27 (IO43)
A1: BUS.1, GLUE.56 (IO86)
A2: BUS.3, GLUE.58 (IO91)
A3: BUS.5, GLUE.61 (IO94)
A4: BUS.7, GLUE.60 (IO93)
A5: BUS.9, GLUE.63 (IO97)
A6: BUS.11, GLUE.65 (IO101)
A7: BUS.13, GLUE.64 (IO99)
A8: BUS.15, GLUE.67 (IO104)
A9: BUS.17, GLUE.69 (IO107)
A10: BUS.19, GLUE.68 (IO105)
A11: BUS.21, GLUE.70 (IO109)
A12: BUS.23, GLUE.73 (IO115)
A13: BUS.25, GLUE.76 (IO120)
A14: BUS.27, GLUE.74 (IO117)
A15: BUS.29, GLUE.80 (IO126)
A16: BUS.31, GLUE.75 (IO118)
A17: BUS.33, GLUE.77 (IO123)
A18: BUS.35, GLUE.79 (IO125)
A19: BUS.37, GLUE.81 (IO128)
A20: BUS.39, GLUE.4 (IO16)
A21: CTRL.9, GLUE.24 (IO46)
A22: CTRL.11, GLUE.22 (IO17)
A23: CTRL.13, GLUE.20 (IO21)
A31: CTRL.15, GLUE.18 (IO24)
CLK25: CTRL.1, GLUE.83 (GCLK1)
D0: D-LO.6, IC2.18 (B1)
D1: D-LO.8, IC2.16 (B3)
D2: D-LO.10, IC2.14 (B5)
D3: D-LO.12, IC2.12 (B7)
D4: D-LO.14, IC3.18 (B1)
D5: D-LO.16, IC3.16 (B3)
D6: D-LO.18, IC3.14 (B5)
D7: D-LO.20, IC3.12 (B7)
D8: D-LO.22, IC4.18 (B1)
D9: D-LO.24, IC4.16 (B3)
D10: D-LO.26, IC4.14 (B5)
D11: D-LO.28, IC4.12 (B7)
D12: D-LO.30, IC5.18 (B1)
D13: D-LO.32, IC5.15 (B4)
D14: D-LO.34, IC5.13 (B6)
D15: D-LO.36, IC5.11 (B8)
D16: BUS.10, IC2.17 (B2)
D17: BUS.12, IC2.15 (B4)
D18: BUS.14, IC2.13 (B6)
D19: BUS.16, IC2.11 (B8)
D20: BUS.18, IC3.17 (B2)
D21: BUS.20, IC3.15 (B4)
D22: BUS.22, IC3.13 (B6)
D23: BUS.24, IC3.11 (B8)
D24: BUS.26, IC4.17 (B2)
D25: BUS.28, IC4.15 (B4)
D26: BUS.30, IC4.13 (B6)
D27: BUS.32, IC4.11 (B8)
D28: BUS.34, IC5.17 (B2)
D29: BUS.36, IC5.16 (B3)
D30: BUS.38, IC5.14 (B5)
D31: BUS.40, IC5.12 (B7)
FC0: CTRL.19, GLUE.12 (IO3)
FC1: CTRL.17, GLUE.16 (IO27)
GLUE-TCK: GLUE.62 (TCK/IO96)
GLUE-TDI: GLUE.14 (IO32/TDI)
GLUE-TDO: GLUE.71 (TDO/IO112)
GLUE-TMS: GLUE.23 (IO48/TMS)
GND: BUS.6, BUS.8, C1.2, C2.2, C3.2, C4.2, C5.2, C6.2, C7.2, C8.2, C9.-, C17.-, CTRL.2, CTRL.3, D-LO.2, D-LO.4, D-LO.38, D-LO.40, GCLK2.3, GLUE.7 (GND), GLUE.19 (GND), GLUE.32 (GND), GLUE.42 (GND), GLUE.47 (GND), GLUE.59 (GND), GLUE.72 (GND), GLUE.82 (GND), IO5.3, IO6.3, IO8.3, IO11.3, IO13.3, OE1.3, POWER.2, POWER.3, SIMM.1, SIMM.39, SIMM.72
IO5: GLUE.11 (IO5), IO5.2
IO6: GLUE.10 (IO6), IO6.2
IO8: GLUE.9 (IO8), IO8.2
IO11: GLUE.8 (IO11), IO11.2
IO13: GLUE.6 (IO13), IO13.2
OE1: GLUE.84 (OE1), OE1.2
OE2-GCLK2: GCLK2.2, GLUE.2 (OE2-GCLK2)
R/!W: CTRL.16, GLUE.21 (IO19)
SIMM-A0: GLUE.33 (IO64), R1.1
SIMM-A0-R: R1.2, SIMM.12
SIMM-A1: GLUE.34 (IO61), R2.1
SIMM-A1-R: R2.2, SIMM.13
SIMM-A2: GLUE.35 (IO59), R3.1
SIMM-A2-R: R3.2, SIMM.14
SIMM-A3: GLUE.36 (IO57), R4.1
SIMM-A3-R: R4.2, SIMM.15
SIMM-A4: GLUE.37 (IO56), R5.1
SIMM-A4-R: R5.2, SIMM.16
SIMM-A5: GLUE.39 (IO53), R6.1
SIMM-A5-R: R6.2, SIMM.17
SIMM-A6: GLUE.40 (IO51), R7.1
SIMM-A6-R: R7.2, SIMM.18
SIMM-A7: GLUE.44 (IO65), R9.1
SIMM-A7-R: R9.2, SIMM.28
SIMM-A8: GLUE.46 (IO69), R11.1
SIMM-A8-R: R11.2, SIMM.31
SIMM-A9: GLUE.48 (IO72), R12.1
SIMM-A9-R: R12.2, SIMM.32
SIMM-A10: GLUE.41 (IO49), R8.1
SIMM-A10-R: R8.2, SIMM.19
SIMM-A11: GLUE.45 (IO67), R10.1
SIMM-A11-R: R10.2, SIMM.29
SIMM-D0: IC2.2 (A1), SIMM.2
SIMM-D1: IC2.4 (A3), SIMM.4
SIMM-D2: IC2.6 (A5), SIMM.6
SIMM-D3: IC2.8 (A7), SIMM.8
SIMM-D4: IC3.2 (A1), SIMM.20
SIMM-D5: IC3.4 (A3), SIMM.22
SIMM-D6: IC3.6 (A5), SIMM.24
SIMM-D7: IC3.8 (A7), SIMM.26
SIMM-D8: IC4.2 (A1), SIMM.49
SIMM-D9: IC4.4 (A3), SIMM.51
SIMM-D10: IC4.6 (A5), SIMM.53
SIMM-D11: IC4.8 (A7), SIMM.55
SIMM-D12: IC5.2 (A1), SIMM.57
SIMM-D13: IC5.5 (A4), SIMM.61
SIMM-D14: IC5.7 (A6), SIMM.63
SIMM-D15: IC5.9 (A8), SIMM.65
SIMM-D16: IC2.3 (A2), SIMM.3
SIMM-D17: IC2.5 (A4), SIMM.5
SIMM-D18: IC2.7 (A6), SIMM.7
SIMM-D19: IC2.9 (A8), SIMM.9
SIMM-D20: IC3.3 (A2), SIMM.21
SIMM-D21: IC3.5 (A4), SIMM.23
SIMM-D22: IC3.7 (A6), SIMM.25
SIMM-D23: IC3.9 (A8), SIMM.27
SIMM-D24: IC4.3 (A2), SIMM.50
SIMM-D25: IC4.5 (A4), SIMM.52
SIMM-D26: IC4.7 (A6), SIMM.54
SIMM-D27: IC4.9 (A8), SIMM.56
SIMM-D28: IC5.3 (A2), SIMM.58
SIMM-D29: IC5.4 (A3), SIMM.60
SIMM-D30: IC5.6 (A5), SIMM.62
SIMM-D31: IC5.8 (A7), SIMM.64
SIZ0: CTRL.8, GLUE.28 (IO40)
SIZ1: CTRL.6, GLUE.30 (IO37)
VCC: BUS.2, BUS.4, C1.1, C2.1, C3.1, C4.1, C5.1, C6.1, C7.1, C8.1, C9.+, C17.+, D-LO.1, D-LO.3, D-LO.37, D-LO.39, GCLK2.1, GLUE.3 (VCC), GLUE.13 (VCCIO), GLUE.26 (VCCIO), GLUE.38 (VCCIO), GLUE.43 (VCC), GLUE.53 (VCCIO), GLUE.66 (VCCIO), GLUE.78 (VCCIO), IO5.1, IO6.1, IO8.1, IO11.1, IO13.1, OE1.1, POWER.4, SIMM.10, SIMM.30, SIMM.59
