techav-homebrew/Wrap030/(commit log)

2024-05-12 Assemble Mandelbrot to run from disk
2024-09-27 8b expansion boards
    [039301240.stp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]
2024-10-13 remove debug print statements
2025-01-04 remove remaining debug print statements
2025-01-06 Add 8-port serial expansion board
    [OctoCom.kicad_pcb, OctoCom.kicad_sch]
2025-01-12 rework octocom logic to use 22V10 for speed
    [OctoCom.kicad_pcb, OctoCom.kicad_sch]
2025-01-12 Add device selection LEDs
    [OctoCom.kicad_sch]
2025-01-13 Move from DE9 to RJ45 for serial ports
    [OctoCom.kicad_sch]
2025-03-29 Add kicad working files to gitignore
2025-03-29 Cherry-pick from cleanup archive
    [ATX-PSU_8b.kicad_pcb, ATX-PSU_8b.kicad_sch, BOM_Wrap030-ITX.csv, BOM_Wrap030.xlsx, Bus-Ctrl.kicad_sch, IRQ.kicad_sch, ISA-IDE-Con.kicad_sch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]
2025-04-03 Mainboard Glue - Remove video cycles
    - Remove custom video cycles used for interfacing SE-VGA card
2025-04-04 Rework Memory Map
    - Reduce ROM wait states to 3 (for 55ns ROM at 50MHz)
    - Rework memory map for contiguous 16MB RAM at address 0
    - Remove SRAM synchronous bus cycles
    - Add Function Code checking for non-CPU space cycles
    - Add interrupt autovector cycle
    - Update MultiBasic linker for new memory map
    [aciacycle.sv, glue030.sv, memcycle.sv]
2025-04-11 Bus cycle fixes
    - assert DSACK for overlay cycles
    - assert Cache Inhibit for all cycles above 2GB boundary
    - hold STERM in high-impedance
    [glue030.sv, memcycle.sv]
2025-04-11 DRAM Controller
    - add initial DRAM control logic
    - add DRAM board Eagle project files
    [Wrap030 Memory.brd, Wrap030 Memory.sch]
2025-04-11 Update MultiBasic bootloader for testing new DRAM
    - move reset vector to runtime ROM address instead of overlay ROM address
    - disable startup overlay prior to memory initialization
    - add print macros which don't touch RAM, to aid debugging
    - add very basic memory tests to confirm RAM is operational before continuing with boot
2025-04-11 DRAM card gerbers
    - add DRAM card gerbers that were omitted from previous DRAM controller commit
    [copper_bottom.gbr, copper_top.gbr, drill_1_16.xln, gerber_job.gbrjob, profile.gbr, silkscreen_bottom.gbr, silkscreen_top.gbr, soldermask_bottom.gbr]
2025-04-12 DRAM Control
    - hold cycle state until cpu de-asserts AS to avoid prematurely starting another DRAM cycle
    - lower refresh interval to reduce resource utilization
    - (temporary) add outputs to debug current state machine state
    [Wrap030 Memory Glue.sv]
2025-04-13 DRAM Control
    - rework DRAM control logic to be cleaner
    [Wrap030 Memory Glue.sv]
2025-04-13 Fix Exception Printing
    - add 4 to offsets when reading stack frame to account for pushed return address
2025-04-13 Bus error fix
    - remove bus error handling from main board glue memcycle
    [memcycle.sv]
2025-04-13 Remove old mainboard glue logic
2025-04-20 Continue developing Bootloader
    - linker script put BSS at top of RAM
    - add machine-specific disk functions for ff diskio.c
    - add register printing helper functions
    - add minimal RAM data bus test to bootloader
2025-04-22 Testing Bootloader
    - add 'wdisk' directory in top-level makefile for clean
    - change startup print functions back to macros for reliabilty
    - set interrupt & supervisor stack pointers after testing RAM
    - add startup tests for assembly & C subroutine branch/return
    - add C print functions for debugging
2025-04-26 Add programmable timer to DRAM glue logic
    add simple test program for timer
2025-04-27 Preemptive Multibasic
    - add timer interrupt support to Multibasic kernel for pre-emptive multitasking.
2025-05-26 modem mode debugging
    - update user memory map to 1MB per user
    - send modem initialization string when enabling modem mode
    - bugfix for toggling modem mode from supervisor console
    - don't immediately switch to modem mode users when call starts
2025-06-04 Clear cache on task switch
    Clearing cache required for stability
    Also:
    - disable MMU debug print
    - improve exception printout
    - update linker for larger exception handling code
2025-06-07 Disable debug print
2025-06-08 Add disk directory print to BASIC
    currently only works with CALL $100178; does not work with DIR
2025-06-08 Add disk directory print to BASIC ("CAT")
    - add `CAT` command to BASIC
    - disable debug print
    - fix CAT table printout formatting
